pavlig43/Doz_stm32f103CBTx/kicad/README.md

# Плата дозатора

Рабочий проект — `doz_030.kicad_pro` в этой папке. Открывайте его в KiCad 10. Схема, плата и настройки проекта хранятся в одном Git-репозитории с прошивкой.

## Состав

- `doz_030.kicad_pro`, `doz_030.kicad_sch`, `doz_030.kicad_pcb` — проект, схема и плата.
- `sym-lib-table`, `fp-lib-table`, `libraries/` — местные библиотеки TrueLib и нужные детали SparkFun. Их пути заданы через `${KIPRJMOD}`.
- `models/` — все STEP-модели, назначенные деталям этой платы. Их форма и привязка сохранены; пути ведут внутрь проекта.
- `output/pdf/` — готовый лист для ЛУТ.
- `tools/build_lut_pdf.py` — сборка двух комплектов на одном листе А4.
- `AGENTS.md` — правила работы с платой и PDF.
- `docs/KICAD_3D_MODEL_ALIGNMENT.md` — правила работы с моделями.

Для открытия проекта не нужны прежняя папка `KiCadFreeCadProject`, переменная `TRUE_LIB` или отдельно установленная библиотека SparkFun. Штатные символы и посадочные места предоставляет KiCad 10; схема также содержит свои встроенные определения символов.

Локальная история редактора, файлы блокировки, временная трассировка и `codexwork/` не входят в Git.

## PDF для ЛУТ

Сначала используйте готовые исходные PDF, если они отражают нужное состояние платы. Сборка сохраняет масштаб 1:1, делает две строки и две колонки: медь слева, надписи справа. Пунктирные рамки реза идут в 1 мм от контура платы, верхняя рамка — в 5 мм от края листа; между контурами плат — 5 мм.

Нужны Python и пакеты `reportlab`, `pdfplumber`, `pypdf`. Из этой папки:

```powershell
python tools/build_lut_pdf.py --board doz_030.kicad_pcb --output output/pdf/doz_030_lut_2sets_A4.pdf --work-dir codexwork/lut_pdf --kicad-cli kicad-cli
```

Команда выводит медь и надписи из сохранённой платы, затем собирает готовый лист. Нужен `kicad-cli` из KiCad 10.

Если есть свежие исходные PDF, добавьте `--copper-pdf <PDF меди>` и `--silk-pdf <PDF надписей>`. Для уже зеркальной меди добавьте `--copper-print-ready`. Перед сборкой проверьте масштаб, отверстия и отражение.

При печати готового листа выбирайте **100%, без подгонки и без дополнительного отражения**.
