pavlig43/Doz_stm32f103CBTx/stm32f030/HARDWARE.md

# Подбор деталей для дозатора на STM32F030

## Выбранные детали питания

Питание: **12 → 5 → 3,3 В**. Берём отдельные детали для своей платы. Стабилизатор 5 В — DPAK (TO-252), стабилизатор 3,3 В — SOT-23-3, конденсаторы — 1206, под пайку паяльником.

| Узел | Деталь | Количество |
| --- | --- | ---: |
| 12 → 5 В | ST L78M05CDT-TR, 5 В, 0,5 А, DPAK (TO-252) | 1 |
| Вход L78M05CDT-TR | Керамический конденсатор 0,47 мкФ, 16 В, 1206; из корзины | 1 |
| Выход L78M05CDT-TR | Керамический конденсатор 0,1 мкФ, 6,6 В, 1206; из набора — 104M | 1 |
| 5 → 3,3 В | UMW XC6206P332MR, 3,3 В, SOT-23-3 | 1 |
| Вход XC6206P332MR | Керамический конденсатор 1 мкФ, 6,6 В, 1206; из набора — 105M | 1 |
| Выход XC6206P332MR | Керамический конденсатор 1 мкФ, 6,6 В, 1206; из набора — 105M | 1 |

Токи оценены по типовым значениям: около 72 мА от 5 В, из них около 33 мА идут через стабилизатор 3,3 В. Расчёт тепла:

- L78M05CDT-TR: `(12 − 5) × 0,072 + 12 × 0,006 ≈ 0,58 Вт`, при собственном токе 6 мА. Для отвода тепла нужна медная площадка на плате.
- XC6206P332MR: `(5 − 3,3) × 0,033 ≈ 0,056 Вт`. Нагрев небольшой, корпус SOT-23-3 подходит.

[Документ ST L78M](https://www.st.com/resource/en/datasheet/l78m.pdf), [документ UMW XC6206](https://static.chipdip.ru/lib/848/DOC018848972.pdf).

## МК и обвязка

МК — **STM32F030F4P6, TSSOP-20**, питание 3,3 В. Конденсаторы — 1206, из набора; их напряжение принимаем равным 6,6 В.

| Узел | Деталь | Количество |
| --- | --- | ---: |
| МК | STM32F030F4P6, TSSOP-20 | 1 |
| Питание VDD | Керамический конденсатор 100 нФ; в наборе — 104M | 1 |
| Питание VDD | Керамический конденсатор 4,7 мкФ; в наборе — 475M | 1 |
| Питание VDDA | Керамический конденсатор 10 нФ; в наборе — 103M | 1 |
| Питание VDDA | Керамический конденсатор 1 мкФ; в наборе — 105M | 1 |
| Сброс NRST | Керамический конденсатор 100 нФ; в наборе — 104M | 1 |
| BOOT0 к земле | Резистор 10 кОм, 1206, 1% | 1 |

Это детали сверх тех, что выбраны для стабилизаторов. Конденсаторы питания МК ставим как можно ближе к его выводам.

### Конденсаторы из набора

Всего на одну плату, включая обвязку стабилизаторов. Напряжение конденсаторов из набора принимаем равным **6,6 В**.

| Маркировка | Ёмкость | Количество |
| --- | --- | ---: |
| 103M | 10 нФ | 1 |
| 104M | 100 нФ | 3 |
| 105M | 1 мкФ | 3 |
| 475M | 4,7 мкФ | 1 |

[Документ ST STM32F030, схема питания — раздел 6.1.6](https://www.st.com/resource/en/datasheet/stm32f030c6.pdf).

## Мотор

Питание — **12 В, пусковой ток до 3 А**. Затвор IRLR2905 управляется напрямую от GPIO STM32F030 (3,3 В) через резистор.

| Узел | Деталь | Количество |
| --- | --- | --- |
| Силовой ключ | IRLR2905, DPAK (TO-252) | 1 |
| Защитный диод двигателя | SS56, 5 А, 60 В, SMC | 1 |
| Резистор между GPIO и затвором | 220 Ом, 1206, 0,125 Вт | 1 |
| Подтяжка затвора к GND | 10 кОм, 1206, 0,125 Вт | 1 |
| Подавление помех двигателя | Керамический конденсатор 100 нФ, 50 В, выводной | 1 |

### Подключение

- IRLR2905: Drain → минус двигателя, Source → GND; плюс двигателя → +12 В.
- SS56: параллельно двигателю, катод к +12 В, анод к Drain.
- Конденсатор 100 нФ: непосредственно между контактами двигателя.
- GPIO STM32 → резистор 220 Ом → Gate IRLR2905.
- Gate IRLR2905 → резистор 10 кОм → Source (GND).
- Земля STM32 и минус питания 12 В соединены.

### Логика управления

- GPIO HIGH (3,3 В) — включение двигателя.
- GPIO LOW (0 В) — выключение двигателя.
- GPIO в высокоомном состоянии — затвор стянут к GND, двигатель выключен.

Для IRLR2905 максимальное сопротивление открытого канала при 3,3 В на затворе в даташите не задано. Расчёт потерь 0,27 Вт при затворе 5 В к этой схеме не относится; потери при 3,3 В определяют по измеренному падению напряжения Drain–Source под нагрузкой: `P = I × VDS`.

Источники: [AlexGyver — драйверы коллекторных моторов, раздел «Мосфет»](https://alexgyver.ru/lessons/dc-motors/), [AlexGyver — подключение MOSFET](https://alexgyver.ru/lessons/mosfet/), [Infineon — IRLR2905](https://www.infineon.com/assets/row/public/documents/24/49/infineon-irlr2905-datasheet-en.pdf), [Pololu — подавление помех двигателя](https://www.pololu.com/docs/0J15/9).
