pavlig43/Doz_stm32f103CBTx/PROJECT_DESCRIPTION.md

# Проект весового дозатора

Состояние на 12 октября 2026 года.

## Назначение

Прошивка весового дозатора на STM32. В проекте предусмотрены измерение веса через HX711, управление мотором, LCD, энкодер с кнопкой, потенциометр и сохранение настроек во Flash.

В настройках заложены целевой вес, вес предварительной остановки, длительность импульса дозирования и коэффициент калибровки весов. Подробный порядок запуска и выполнения дозы на этом этапе не описан.

Разработка идёт на STM32F103. Для готового устройства рассматривается F0 либо тот же F103. При выборе F0 будет создан отдельный проект; точная модель пока не выбрана.

## Платформа

| Параметр | Текущий вариант |
| --- | --- |
| Микроконтроллер | STM32F103CBT6, корпус LQFP48 |
| Память по скрипту компоновки | Flash 128 КБ, RAM 20 КБ |
| Язык и библиотеки | C11, STM32 HAL |
| Среда | CLion, CMake, ARM GCC |
| Настройка периферии | STM32CubeMX, файл `Doz_stm32f103CBTx.ioc` |

## Занятые пины

| Пин | Назначение | Режим / периферия |
| --- | --- | --- |
| PA0 | Первая линия энкодера | TIM2_CH1, вход без подтяжки |
| PA1 | Вторая линия энкодера | TIM2_CH2, вход без подтяжки |
| PC13 | Кнопка энкодера, `Enc_But` | Вход с подтяжкой вверх; нажатие — низкий уровень |
| PA5 | Потенциометр, `poten` | Аналоговый вход ADC1_IN5 |
| PA9 | Управление мотором, `Motor` | GPIO push-pull, начальный уровень высокий — мотор остановлен |
| PA10 | Данные HX711, `DOUT` | Вход без подтяжки |
| PA11 | Тактовый сигнал HX711, `SCK` | GPIO push-pull, начальный уровень низкий |
| PB6 | Тактирование LCD по I2C | I2C1_SCL, alternate open-drain |
| PB7 | Данные LCD по I2C | I2C1_SDA, alternate open-drain |
| PD0 / OSC_IN | Внешний кварц | HSE |
| PD1 / OSC_OUT | Внешний кварц | HSE |
| PA13 | Отладка и прошивка | SWDIO |
| PA14 | Отладка и прошивка | SWCLK |

Пины сверены с `main.h`, `gpio.c`, настройками ADC, I2C, TIM2 и файлом CubeMX.

## Тактирование

| Узел | Частота |
| --- | --- |
| HSE, внешний кварц | 8 МГц |
| PLL | HSE × 9 |
| SYSCLK / HCLK, процессор | 72 МГц |
| APB1 | 36 МГц |
| Таймеры APB1, в том числе TIM2 | 72 МГц |
| APB2 | 72 МГц |
| TIM1 | 72 МГц при текущей настройке APB2 |
| ADC1 | 12 МГц, APB2 / 6 |

TIM2 получает 72 МГц, хотя APB1 работает на 36 МГц: при делителе APB1 равном 2 частота таймеров удваивается относительно частоты шины.

## Таймеры и периферия

| Узел | Назначение и настройка | Состояние |
| --- | --- | --- |
| TIM2 | Энкодер, режим TI12; `PSC = 0`, `ARR = 65535`; фильтры входов CH1 = 5, CH2 = 0 | Настроен в `tim.c`; запуск счёта находится в `Enc_Init()` |
| TIM1 | Короткие паузы при чтении HX711; внутренний счётчик с шагом 1 мкс, без GPIO и прерываний | Настроен в `tim.c`; запуск находится в `HX_Init()` |
| SysTick | Системное время HAL, `HAL_GetTick()` и `HAL_Delay()` | Используется HAL |
| ADC1 | Один канал IN5, 12 бит, одиночное преобразование с программным запуском | Настроен; `poten.c` читает 0…4095 и переводит в заданный диапазон |
| I2C1 | LCD 16×2, скорость 100 кГц; 7-битный адрес дисплея `0x27` | Настроен; в вызов HAL адрес передаётся как `0x27 << 1` |

TIM3 и TIM4 в текущем проекте не настроены. TIM1 для задержек не требует перенастройки PA9, PA10 или PA11: эти пины остаются GPIO.

В `enc.c` четыре отсчёта TIM2 объединяются в один шаг энкодера. В `lcd.c` хранятся две строки по 16 символов; проверка обновления идёт с интервалом 200 мс, передаются изменившиеся строки.

В `motor.c` заложены уровни: низкий — пуск, высокий — остановка. Управление идёт через GPIO, ШИМ для мотора сейчас не настроен. При запуске вызывается `Motor_Stop()`; пуск мотора пока не подключён.

## Настройки и калибровка

| Настройка | Значение по умолчанию | Хранение |
| --- | --- | --- |
| Целевой вес | 3000 г | `FEE_WEIGHT`, ID 0 |
| Коэффициент HX711 | `1.0f` | Младшие 16 бит — ID 1, старшие — ID 2 |
| Вес предварительной остановки | 50 г | `FEE_STOP_BEFORE_TARGET_WEIGHT`, ID 3 |
| Длительность импульса дозирования | 500 мс | `FEE_TIME_DOSING_PULSE`, ID 4 |

В текущем коде калибровки сначала усредняются пять отсчётов без груза, затем пять отсчётов с грузом 1 кг. Коэффициент рассчитывается как `(raw_1kg - raw_zero) / 1000`, то есть число отсчётов на грамм. Перевод отсчёта в граммы: `(raw - raw_zero) / factor`.

Настройки сохраняются модулем `fee.c` во Flash: начало `0x0800FC00`, размер страницы 1024 байта, номер страницы 63. Это адрес, заданный в коде; для STM32F103CB со 128 КБ Flash эта страница не последняя.

Запись занимает четыре байта: 16-битный ID и 16-битное значение. Чтение выбирает последнюю запись с нужным ID. При заполнении страницы код стирает её и переносит текущие значения. Биты коэффициента `float` хранятся в двух записях. `FEE_Settings_Init()` загружает настройки и восстанавливает коэффициент.

## Основные файлы

Пути ниже указаны от корня проекта. Код CubeMX остаётся в `Core`, HAL и CMSIS — в `Drivers`. Наши библиотеки лежат в `lib`, код дозатора — в `app`. Файлы `.c` и `.h` каждого нашего модуля лежат рядом. В корне `app` лежат `app.c` и `app.h`; модули `work`, `settings` и `doz_fee` имеют свои папки.

| Файл / модуль | За что отвечает |
| --- | --- |
| `Core/Src/main.c` | Запуск HAL, настройка частот и периферии |
| `Core/Src/gpio.c`, `adc.c`, `i2c.c`, `tim.c` | Настройки периферии, созданные CubeMX |
| `lib/hx/hx.c` | Чтение HX711 с паузами через TIM1, среднее пяти проб, тара и вес в граммах |
| `lib/enc/enc.c` | Энкодер и короткое / длинное нажатие кнопки |
| `lib/lcd/lcd.c` | Запуск и вывод двух строк LCD |
| `lib/fee/fee.c` | Хранение записей во Flash |
| `lib/motor/motor.c` | Управление мотором |
| `lib/poten/poten.c` | Чтение потенциометра |
| `lib/utils/utils.c` | Пересчёт диапазона значений |
| `app/settings/settings.c` | Меню настроек и калибровка весов |
| `app/doz_fee/doz_fee.c` | Параметры дозатора и загрузка из Flash |
| `app/app.c` | Главное меню и выбор режима |
| `app/work/work.c` | Рабочий режим пока пуст |

Перенос меняет только пути: функции, их вызовы и связи между модулями сохранены. `main.c` остаётся прежним; сборка находит заголовки через пути из корневого `CMakeLists.txt`. Файлы в `cmake/stm32cubemx` остаются под управлением CubeMX. Модуль `hx` пока связан с `doz_fee`.

## Текущее состояние

В `main.c` настроены GPIO, ADC1, I2C1, TIM2 и TIM1. При запуске мотор останавливается, ADC проходит калибровку, загружаются настройки Flash, запускаются HX711, LCD и энкодер. Основной цикл опрашивает энкодер и кнопку, вызывает меню и обновляет LCD.

Рабочий режим пока пуст. Кнопка читается опросом с фильтром дребезга 30 мс; порог длинного нажатия — 600 мс. Длинное нажатие возвращает в меню. Меню даёт доступ к настройкам и калибровке по пяти новым пробам без груза и с грузом 1 кг. Алгоритм дозирования ещё не написан.

Обсуждение чтения HX711 через TIM1 сохранено в [HX711_TIM1.md](HX711_TIM1.md); текущий код находится в `lib/hx/hx.c`.

Последняя сборка Release с суммами HX711 на `int32_t` и пустым рабочим режимом прошла без ошибок и предупреждений: 14 252 байта Flash и 2432 байта RAM. Короткое и длинное нажатия, дребезг и переход счётчиков через ноль проверены на ПК с подменой HAL. На плате прошивка не проверялась.
