pavlig43/Doz_stm32f103CBTx/PROTEUS_PROGRESS.md

# Дозатор в Proteus 8.13: что сделано и где остановились

Состояние на 17 октября 2026 года.

Проект прошивки: `C:\Users\user\CLionProjects\Doz_stm32f103CBTx`.

Этот файл дополняет `PROTEUS_HANDOFF.md`. Старый файл содержит общий план дозатора; здесь записан ход работы с библиотеками и схемой мотора.

## LCD: запуск подтверждён 17 октября 2026 года

В схеме `C:\Users\user\Documents\New Project.pdsprj` нашли разрыв: SDA и SCL экрана не входили в цепи PB7 и PB6. После соединения проводами LCD начал принимать данные. Прибор I2C и резисторы подтяжки должны быть подключены к этим же цепям; совпадение видимых подписей ещё не доказывает контакт.

Затем модель TEP сообщила `TOO FAST`, а вместо текста были неверные символы. В `LCD_Init()` первые посылки шли через передачу полного байта, что сбивало переход в 4-битный режим. Проверенная правка сначала сбрасывает E, затем передаёт одиночные полубайты 3, 3, 3, 2 с задержками. Пользователь подтвердил, что с ней экран заработал.

Этот же код перенесён в `lib/lcd/lcd.c`. После очистки оставлен один ELF: `C:\Users\user\CLionProjects\Doz_stm32f103CBTx\build\Debug\Doz_stm32f103CBTx.elf`. Обычный профиль CLion `Debug - Debug` теперь собирает его с `-O0 -g3 -gdwarf-2`; ASM тоже использует DWARF 2. `cmake/proteus-debug.cmake` готовит в каталоге сборки стандартные библиотеки без их старых отладочных данных DWARF 5. Проверено: все 25 отладочных единиц итогового ELF имеют версию 2, а код Flash побайтно совпадает с проверенной пользователем версией. Новую версию на реальной плате ещё не проверяли; прежняя версия там работала со слов пользователя.

По прямому запросу пользователя удалены отдельные сборки ProteusDwarf2 и ProteusLcdInit, диагностические дампы, старый ELF Release, ELF без отладочных данных и старая схема `simulation/proteus/Doz_STM32F103C8.pdsprj` с копиями. Сохранены только два проекта схем: `C:\Users\user\Documents\New Project.pdsprj` и `C:\Users\user\Documents\Doz_STM32F030F4P6TR.pdsprj`. Их резервные копии удалены; новые копии не создавать. Сами два проекта при очистке не менялись. В сохранённом New Project ещё указан старый путь ProteusLcdInit: в U1 нужно выбрать единственный ELF из Debug.

## Как продолжать

Пользователь сам ставит детали и соединяет их в Proteus. Агент ведёт его по шагам: по 1–3 действия, затем проверка по ответу или скриншоту. Для каждого соединения указывать оба конца. Не считать схему готовой по одному виду подписей.

## Что проверили и установили

- Пользователь перешёл на Proteus 8.13. Проверенная версия `PDS.EXE` — `8.13.31525`.
- Папка установки: `C:\Program Files (x86)\Labcenter Electronics\Proteus 8 Professional`.
- По одному номеру версии нельзя судить о числе моделей. Состав библиотек зависит и от сторонних файлов; совместимость каждой модели надо проверять отдельно.
- Прошивку в ходе этой работы не меняли. Симуляцию всего дозатора ещё не проверяли.

### LCD 16×2 с I2C в одной детали

Нашли штатную деталь `JHD-2X16-I2C`, но она не заменяет связку LCD + PCF8574 для текущего драйвера прошивки.

Установили библиотеку TEP с LCD и PCF8574 в одной детали:

- `C:\Program Files (x86)\Labcenter Electronics\Proteus 8 Professional\DATA\LIBRARY\TEPLCD.LIB`
- `C:\Program Files (x86)\Labcenter Electronics\Proteus 8 Professional\DATA\MODELS\TEPLCD.DLL`

В поиске деталей вводить `I2CLCD16X2`; выбранный вариант — `I2CLCD16X2BLUETEP`.

Для прошивки нужен адрес `0x27` и связи PCF8574: P0 → RS, P1 → RW, P2 → E, P3 → подсветка, P4…P7 → D4…D7. При выборе модели сверили эти параметры. Работу экрана с прошивкой ещё надо проверить запуском.

Архив и распакованные файлы лежат в `C:\Users\user\Downloads\Proteus-LCD-I2C-TEP`.

Источник: [LCD Library for Proteus V3.0, TEP](https://www.theengineeringprojects.com/2026/10/lcd-library-for-proteus-v30.html).

### Поиск модуля мотора

Сначала установили библиотеку `L298MotorDriverTEP`, но пользователь отверг этот вариант: много выводов, не похож на его модуль. В текущей схеме L298 не нужен; его библиотеку не удаляли.

У физического модуля пользователя пять выводов:

| Надпись | Назначение |
| --- | --- |
| `+` | Плюс питания мотора |
| `−` | Минус питания мотора |
| `LOAD` | Выход к минусу мотора |
| `GND` | Земля входного сигнала |
| `PWM` | Вход управления |

По этим выводам модуль похож на платы LR7843 / D4184 / FR120N с оптопарой. Точную модель платы не установили. Готовую подходящую модель Proteus не нашли.

Решили собрать аналог на PC817 и IRLZ44N, затем сохранить его для повторного применения. Это схема для проверки работы дозатора; точное совпадение с внутренней схемой физического модуля не доказано.

## Что уже стоит на листе

По последнему скриншоту пользователь разместил:

| Деталь | Обозначение и значение |
| --- | --- |
| Источник питания | BAT1, 12 V |
| Мотор | MOTOR-DC |
| MOSFET | Q1, IRLZ44N |
| Оптопара | U2, PC817 |
| Резистор входа оптопары | R1, 330 Ом |
| Подтяжка затвора | R2, 10 кОм |
| Резистор затвора | R3, 100 Ом |
| Диод мотора | D1, 1N4007 |

Изначально предлагали 1N5819, но в установке его не нашли. Остановились на доступном 1N4007. Его допустимый средний ток — 1 А, не 1 мА. Для быстрой ШИМ выбор диода надо пересмотреть; текущая прошивка включает и выключает мотор медленными импульсами.

## Связи через имена без длинных проводов

Показали режим `TERMINALS` → `DEFAULT`. Две клеммы с одним именем образуют одну электрическую цепь. Так соединяем, например, мотор и сток Q1 через имя `LOAD`.

Длинный провод между ними не нужен. Точка подключения клеммы должна точно совпасть с концом вывода на сетке. Если между ними есть зазор, нужен короткий провод. Надпись рядом с выводом сама по себе его не соединяет.

## Где остановились: у Q1 перепутаны две клеммы

На последнем скриншоте:

- Плюс BAT1 связан с цепью `12V`, минус — с `GND_INPUT`.
- Один вывод мотора связан с `12V`, другой — с `LOAD`.
- **У Q1 верхний вывод ошибочно связан с `GND_INPUT`, нижний — с `LOAD`.**
- R1, R2, R3 и U2 ещё не соединены. D1 тоже ещё не соединён.

Последнее указание пользователю — поменять у Q1 две клеммы:

| Вывод Q1 IRLZ44N в текущем положении | Нужная цепь |
| --- | --- |
| Верхний D, № 2 — сток | `LOAD` |
| Нижний S, № 3 — исток | `GND_INPUT` |
| Левый G, № 1 — затвор | Пока свободен; подключим через R3 |

Пользователь спросил, что перепутано, если G свободен. Уточнили: речь о D и S; свободный G к этой ошибке не относится. Подтверждения, что клеммы уже переставлены, пока нет.

Последний скриншот: `C:\Users\user\AppData\Local\Temp\codex-clipboard-c8edd13f-8dc7-4f21-8fc0-0070319277e5.png`.

## Как завершить схему мотора

Ниже — намеченные связи, а не отчёт о готовой схеме. Давать их пользователю небольшими порциями.

### Силовая часть

1. Плюс питания 12 V → один вывод мотора.
2. Второй вывод мотора → `LOAD` → D Q1, № 2.
3. S Q1, № 3 → минус питания мотора. На текущем листе эта цепь называется `GND_INPUT`.
4. Катод D1, сторона с чертой → `12V`.
5. Анод D1 → `LOAD`.

В текущем положении D1 катод справа, анод слева. Диод подключается параллельно мотору.

### Вход и затвор: низкий уровень включает мотор

В `lib\motor\motor.c` проверено: `Motor_Run()` задаёт низкий уровень, `Motor_Stop()` — высокий. Поэтому для этого аналога намечена схема с таким же действием входа.

Выводы PC817 на скриншоте: A № 1 сверху слева, K № 2 снизу слева, C № 4 сверху справа, E № 3 снизу справа.

| Откуда | Куда |
| --- | --- |
| Вход `PWM` от PA9 | R1, 330 Ом |
| Другой конец R1 | A PC817, № 1 |
| K PC817, № 2 | Сигнальная земля `GND` контроллера |
| C PC817, № 4 | Узел `GATE_CTL` |
| E PC817, № 3 | Минус питания мотора, сейчас `GND_INPUT` |
| `12V` | R2, 10 кОм |
| Другой конец R2 | `GATE_CTL` |
| `GATE_CTL` | R3, 100 Ом |
| Другой конец R3 | G Q1, № 1 |

При высоком уровне на `PWM` оптопара открывается и тянет затвор вниз: мотор выключен. При низком уровне оптопара закрыта, R2 поднимает затвор к 12 V: мотор включён.

Название `GND_INPUT` на текущем листе относится к минусу батареи. Не путать его с отдельным входом `GND` оптопары. Если нужно сохранить развязку, не объединять эти цепи общей меткой земли. Перед сборкой входной части проверить, какие сети создают выбранные символы в Proteus.

PC817 и подтяжка 10 кОм выбраны для медленного включения и выключения в этой проверке. Работу на высокой частоте ШИМ не проверяли. При отключённом входе эта схема включает мотор через R2; остановка при обрыве входа здесь не обеспечена.

## Что ещё проверить

- Исправлены ли D и S Q1 и есть ли электрический контакт у всех клемм.
- Правильно ли подключён диод.
- Выключается ли мотор при высоком уровне входа и включается ли при низком.
- Как ведёт себя схема при запуске прошивки. В старой памятке отмечен возможный низкий начальный уровень PA9; актуальное состояние запуска заново не проверяли.
- Работает ли LCD с текущей прошивкой. Наличие файлов библиотеки ещё не доказывает работу модели.

## Сохранение модуля

Пользователь хочет сгруппировать схему и сохранить блок с пятью выводами. До этого надо завершить связи и проверить пуск и остановку мотора.

В местной справке Proteus нашли два пути:

- Плоский фрагмент схемы можно сохранить как Project Clip (`.PDSCLIP`).
- Для детали с пятью внешними выводами подходит иерархическая схема с внешним файлом `.MOD` и сохранением детали в библиотеку через `Make Device`.

Project Clip не сохраняет содержимое дочерних листов. Нельзя упаковать только внешний блок и считать, что его внутренняя схема тоже попала в клип.

Ни клип, ни готовую деталь пока не создали. Путь к сохранённому проекту Proteus ещё не подтверждён. По общему плану его нужно сохранить в `simulation\proteus\` внутри проекта прошивки.

## Следующий шаг

Проверить по новому скриншоту, что у Q1 верхний D связан с `LOAD`, нижний S — с минусом батареи. Затем подключить D1: катод к `12V`, анод к `LOAD`. После этого перейти к PC817 и резисторам.
