pavlig43/Doz_stm32f103CBTx/kicad/docs/KICAD_3D_MODEL_ALIGNMENT.md

# Работа с 3D-моделями в KiCad

Это главная инструкция для моделей X3D, STEP и FCStd, связанных с футпринтами KiCad. При любой задаче по 3D сначала читать этот файл. Работать по одной модели. KiCad и FreeCAD для проверки вида открывает пользователь сам.

## Главное правило

- «Повернуть» — изменить угол в плоскости платы вокруг Z; высота не меняется. «Развернуть» — перевернуть модель вокруг X или Y.
- Сначала определить, что просит пользователь: изменить файл модели или только её привязку в футпринте. Не подменять одно другим.
- Если пользователь дал путь к STEP, X3D или FCStd либо прямо назвал формат, менять только этот файл. Не менять `.kicad_pcb`, `.kicad_mod`, `offset`, `scale` и `rotate`, даже если ошибка показана в 3D-виде KiCad.
- Файл по доступному локальному пути уже передан для работы. Не просить пользователя прислать или загрузить его в чат.
- При правке файла модели не менять футпринт, площадки, плату и `offset`, `scale`, `rotate`. При правке одной привязки не менять STEP, X3D или FCStd.
- Править ровно тот файл, на который указывает футпринт. Не менять системные модели KiCad, не создавать ссылки, junction и каталоги-накладки.
- Для полного комплекта детали копировать модель в `${MY_LYB}/my_lyb.3dshapes` и ссылаться на неё через `${MY_LYB}`. Не оставлять ссылку на системную модель или случайную копию.
- Не создавать рядом второй файл с тем же именем. Временные файлы держать вне библиотеки.
- До правки отделить ручные изменения пользователя от изменений агента. Ручные правки не отменять.
- Не менять готовую модель без прямого запроса пользователя.
- Масштаб не менять без доказанной ошибки единиц. Если размер модели не совпадает с футпринтом, сообщить точные числа и остановиться.
- Не угадывать по косому снимку. Фото используют только как подсказку; решение принимают по координатам, виду сверху и трём опорным точкам.
- Менять один параметр за раз: X/Y, Z, угол, зеркало, масштаб или форму. После каждой правки делать одну короткую проверку.

## Подготовка

1. Из футпринта выписать путь модели, `offset`, `scale`, `rotate`, угол футпринта и координаты всех нужных площадок.
2. Сверить путь `my_lyb` в таблице футпринтов, значение `${MY_LYB}` и наличие файла.
3. Выбрать опорные точки:
   - центр первого отверстия или вывода задаёт сдвиг;
   - центр второго задаёт поворот и шаг;
   - третья точка вне этой линии проверяет зеркало и сторону.
4. Сравнивать центры отверстий и выводов, а не края корпуса, цвет, пластик или положение надписей.
5. Для рядов контактов проверить число контактов и шаг `2,54 мм` или тот шаг, который указан в футпринте.
6. Для размеров брать источники в таком порядке: прямое указание пользователя, назначенный верным чертёж или футпринт, исходная модель, фото только для вида и стороны установки.

## Расчёт координат

- Сначала считать координаты самой модели, затем применить преобразования футпринта. Нельзя считать сдвиг, забыв про `offset` или поворот.
- Записать формулу и единицы: X3D обычно использует дюймовые единицы VRML/X3D, STEP — миллиметры. Перевод X3D: `1 единица = 2,54 мм`.
- Для X3D учитывать порядок преобразований KiCad: сначала `offset`, затем поворот модели и масштаб. При повороте модели локальные координаты могут поменяться местами по осям; знак оси нельзя выбирать на глаз.
- Для STEP определить, как оси модели соотносятся с осями футпринта. У STEP ось Y может иметь обратный знак относительно вида KiCad.
- Считать одну жёсткую матрицу: перенос и поворот. Зеркало применять только после проверки третьей точки и сообщения пользователю.
- Не менять масштаб как способ исправить сдвиг. Сдвиг исправляется сдвигом, поворот — поворотом.

## X3D

- Сохранять исходную структуру X3D и штатные узлы модели.
- Не добавлять общий узел `kicad_alignment_TRANSFORM`, скрытый корневой перенос или другую временную обёртку. Если такой узел уже добавлен прошлым агентом, перед новой правкой удалить его и вернуть исходную структуру.
- Менять координаты геометрии и штатные `Transform` модели. Не двигать отдельные детали по одной, если ошибка общая для всей модели.
- Для рядов штырей, колодок и разъёмов совмещать оси штырей с центрами отверстий или площадок именно своего футпринта. Проверять число контактов, шаг, сторону колодки, длину выводов и высоту над платой.
- Для деталей, не относящихся к PLS, размеры, форма пластика и длина штырей не считаются стандартными: брать их из исходной модели, чертежа или данных пользователя. Не переносить размеры другой детали.
- Сначала совмещать центры по X и Y, затем проверять общий Z. Не опускать и не поднимать штыри без измерения от плоскости платы.

### PLS и BLS

- Для одного контакта хранить прямой и угловой 90° варианты.
- Исходник для FreeCAD — `.FCStd`, модель для KiCad и обмена — `.step`.
- Размеры ножек должны быть видны в свойствах объектов, а не только внутри слитого тела.

#### Прямые штыри PLS

- Чёрная колодка располагается под платой, длинные концы штырей направлены вниз, короткие проходят через плату вверх.
- Шаг ряда — `2,54 мм`. Оси штырей совмещать с центрами отверстий. Край колодки выступает на `1,27 мм` от оси крайнего штыря.
- От низа платы колодка занимает высоту от `0` до `-2,5 мм`, штыри — от `-8,5` до `+3,25 мм`.
- Сечение штыря — `0,75 × 0,75 мм`. В ряду брать только нужное число мест.
- Если оси модели направлены иначе, поворачивать весь ряд, сохраняя шаг, центры и высоты.

## STEP и FCStd

- STEP править скриптом через Python API FreeCAD, запускать скрипт в `FreeCADCmd`. Окно FreeCAD не открывать и не править модель вручную через интерфейс.
- Править любую STEP-модель через `Placement` в FreeCAD: перенос, поворот и при необходимости зеркало. Форму деталей не менять, если пользователь не просил изменить форму.
- Исходный STEP не перезаписывать до сохранения резервной копии или отдельного исходника. Рабочий итог сохранять по тому же пути только после расчёта и проверки чисел.
- FCStd хранить отдельно от экспортированного STEP. В FCStd проверять дерево объектов, единицы, оси и положение относительно плоскости платы.
- После изменения FCStd экспортировать STEP заново с сохранением единиц и ориентации. Не править STEP как обычный текст.
- Для деталей с выводами совмещать минимум два центра выводов и одну точку вне их ряда. Это выявляет сдвиг, угол и зеркало.
- У сборочного STEP сохранять дерево, цвета и взаимное положение частей. Не выгружать сборку как набор отдельных тел.
- При общем переносе или повороте менять одной матрицей все размещения, перечисленные в корневом узле. Не двигать тела по одному и не менять общий единичный узел, от которого зависят связи.
- FreeCAD может показать `Placement` корневого `App::Part`, но не включить его в экспортированный STEP. Успешный экспорт не доказывает, что сдвиг и поворот записались.
- До выгрузки создать временную папку и проверить, что она существует. После ошибки команды не продолжать и не писать в исходный STEP.
- Сначала выгружать пробный STEP во временную папку, заново открывать именно этот файл и сверять его координаты с расчётом. Исходный STEP заменять только после этой проверки.
- Если после повторного открытия координаты не изменились, оставить `Placement` корневого `App::Part` единичным и умножить одной и той же жёсткой матрицей размещения всех его прямых дочерних частей. Список брать из корневого узла, а не из заранее заданного числа тел.
- Не применять матрицу ко всем `Part::Feature` подряд: вложенная часть может получить двойной сдвиг или поворот. После новой выгрузки ещё раз открыть STEP и проверить габариты, опорные точки и диапазон Z.

## Новая модель FCStd

- STEP брать как образец формы и размеров, а итог строить нативными объектами FreeCAD.
- Начало координат, плоскость установки и оси X/Y/Z связывать с футпринтом. Не переносить модель в центр ради удобного вида.
- Дерево держать чистым: корневой узел, плата, отверстия, крупные детали и разъёмы. Не оставлять импортированный STEP, дубли и черновики.
- Не рисовать текст, дорожки и мелкий декор без прямого запроса.
- Перед сохранением проверить единицы, число выводов, соосность отверстий, сторону пластика и высоты над и под платой.

## Числовая проверка до сохранения

- Преобразовать все точки модели в координаты футпринта с учётом `offset`, `rotate` и `scale`.
- Сравнить каждый проверенный центр с площадкой. Для каждой точки записать `ΔX`, `ΔY` и итоговое расстояние.
- Допуск итогового расстояния — `0,05 мм`. Если хотя бы одна точка вне допуска, модель не сохранять и искать причину: неверная ось, знак, угол, единицы или лишний старый сдвиг.
- Не считать совпадением ситуацию, когда совпал только край, один вывод или косой ракурс.

## Проверка в KiCad

- Проверить путь модели, наличие файла, начало координат, ориентацию и связь с футпринтом отдельно от знака и площадок.
- Проверить вид сверху, затем вид сбоку и косой вид. Вид сверху показывает X/Y, угол и зеркало; вид сбоку — Z.
- STEP сам не вырезает плату. Если в 3D-виде пропал кусок платы, искать замкнутый контур на `Edge.Cuts`.
- В `.kicad_pcb` хранится копия футпринта. После правки библиотечного футпринта вызвать `Инструменты → Обновить посадочные места из библиотеки…`.

## Типовые ошибки

| Симптом | Причина | Что делать |
|---|---|---|
| После экспорта пропали выводы, появилась лишняя деталь или части наложились | Сборочный STEP выгружен как отдельные тела | Вернуть исходный STEP и менять общее размещение сборки |
| Края совпали, но выводы не попали в площадки | Совмещение сделано по корпусу или снимку | Сверять центры площадок и минимум три опорные точки |
| Центры совпали, но номера выводов идут наоборот | Не проверена сторона ряда | Сопоставить физические выводы с номерами площадок и проверить третью точку |
| Модель перевернулась верхом вниз вместо поворота в плане | Перепутаны оси | Для поворота брать Z; разворот вокруг X или Y переворачивает модель |
| Штыри ушли в плату или модель висит над ней | Вместе с X/Y изменён Z | Вернуть прежний Z и считать высоту отдельно |
| После сдвига часть сборки осталась на месте | Изменены не все верхние размещения | Применить одну матрицу ко всем дочерним размещениям корневого узла |
| После общей правки детали продублировались или разъехались | Изменён общий узел, от которого зависят связи | Вернуть общий узел и править перечисленные в нём размещения |
| В FreeCAD сборка сдвинулась или повернулась, а повторно открытый STEP остался прежним | Экспорт не включил `Placement` корневого `App::Part` | Оставить корень единичным, применить одну матрицу к его прямым дочерним размещениям, выгрузить пробный STEP и открыть его заново |
| Плата выглядит по-старому после правки футпринта | В плате осталась старая копия футпринта | Обновить посадочные места из библиотеки |
| Размер модели не совпадает с футпринтом | Ошибка единиц или масштаба | Сравнить точные размеры; масштаб на глаз не подбирать |
| По снимку неясен знак оси или зеркало | Косой вид искажает расстояния | X/Y и угол проверять по координатам и виду сверху |

## Сохранение и отчёт

- Сохранить только то, что просил изменить пользователь: файл модели или её привязку в футпринте. Знак, плату и чужие модели не менять.
- Удалить временные файлы проверки и не оставлять рядом вторую модель с тем же именем.
- В отчёте указать путь модели, что изменено, точный перенос по X/Y/Z, поворот, зеркало, масштаб и таблицу отклонений.
- Явно сообщить, если масштаб не менялся. Если применено зеркало или изменены единицы, отдельно предупредить пользователя.
- После каждой модели остановиться. Пользователь сам открывает KiCad/FreeCAD и проверяет вид сверху, затем косой вид и высоту. К следующей модели переходить только после его ответа.

## Ошибки, которые нельзя повторять

- Не править футпринт, чтобы скрыть ошибку модели.
- Не возвращать общий Z к нулю после того, как высота уже совпала.
- Не опускать штыри или пластик колодки без измерения от плоскости платы.
- Не утверждать, что «всё совпало», по одному косому снимку.
- Не ссылаться на ошибку KiCad без проверки собственных `offset`, `rotate`, осей и лишних узлов X3D.
- Не менять сразу X, Y, Z, угол и масштаб: иначе нельзя понять, что помогло.
- Не переходить к следующей детали, пока пользователь не подтвердил текущую.
