pavlig43/Doz_stm32f103CBTx/hardware/doz_030_lut_2sets_A4.pdf

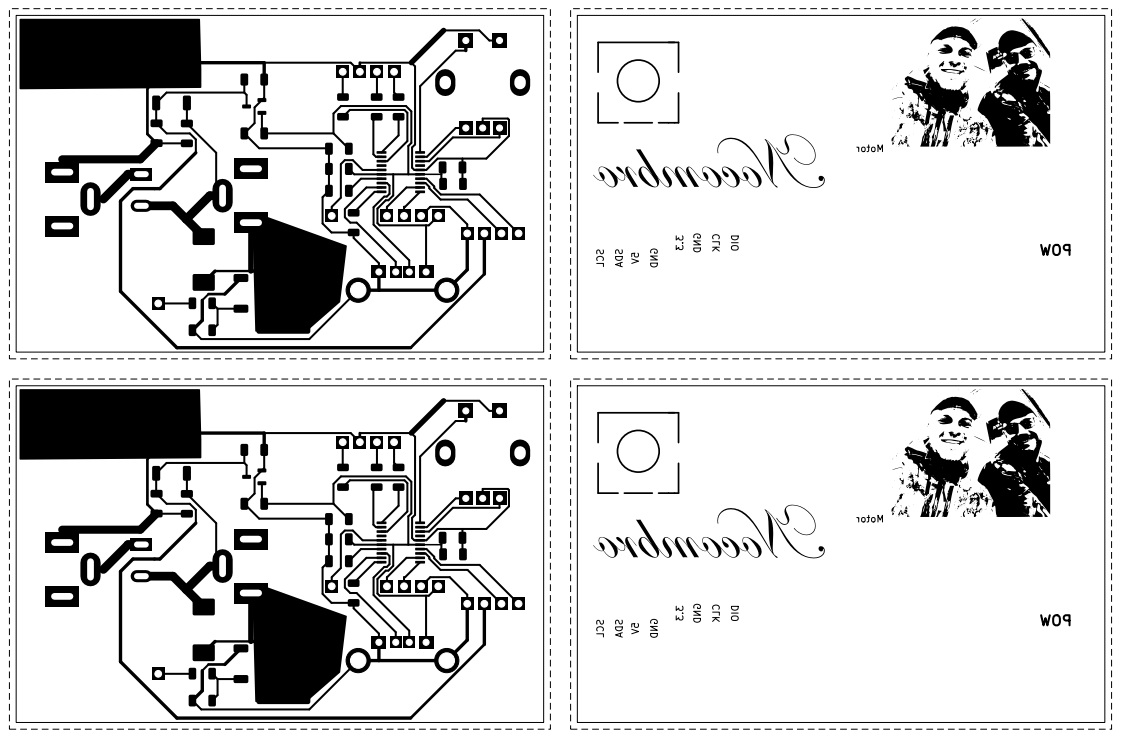
[picture p1: page 1]

SCL SDA 5V GND 3.3 GND CLK DIO POW
