pavlig43/Doz_stm32f103CBTx/kicad/doz_030-B_Silkscreen.pdf

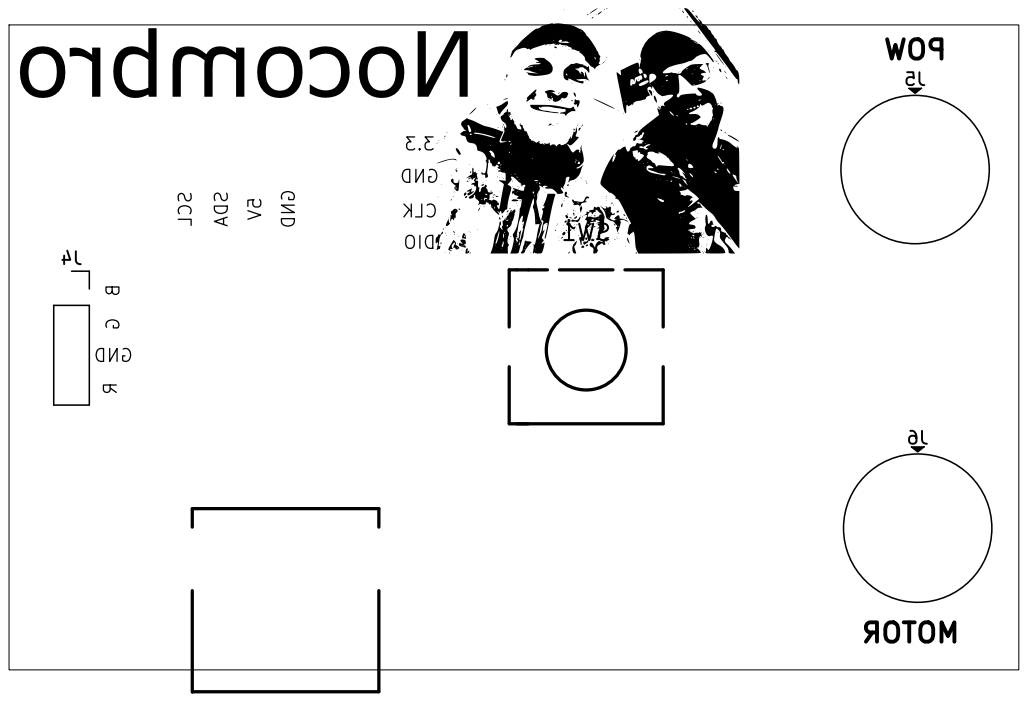
[picture p2: page 1]

GNDR MOTOR SCL SDA 5V GND
