pavlig43/Doz_stm32f103CBTx/kicad/output/pdf/doz_030_lut_2sets_A4_2026-10-29.pdf

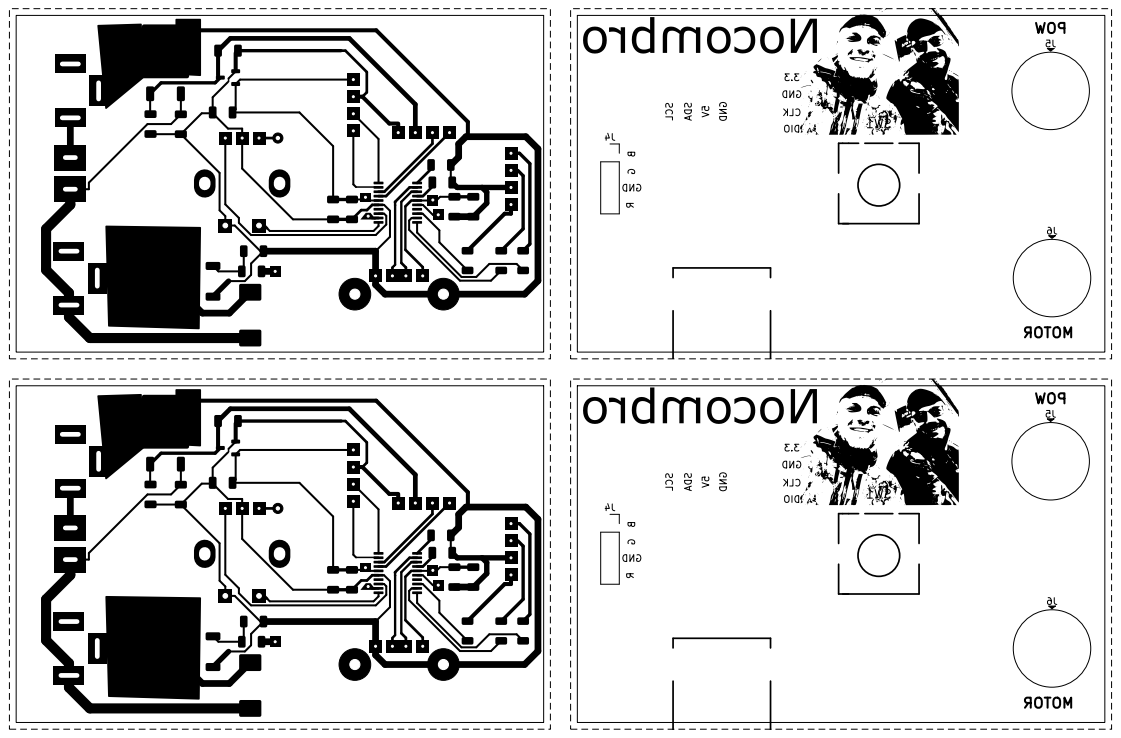
[picture p3: page 1]
GND; 3.3 DIO; CLK; GND R B G POW; MOTOR

J5 SCL SDA 5V GND

SCL SDA 5V GND
