pavlig43/Doz_stm32f103CBTx/doz_030_klem/doz_030_klem-B_Silkscreen.pdf

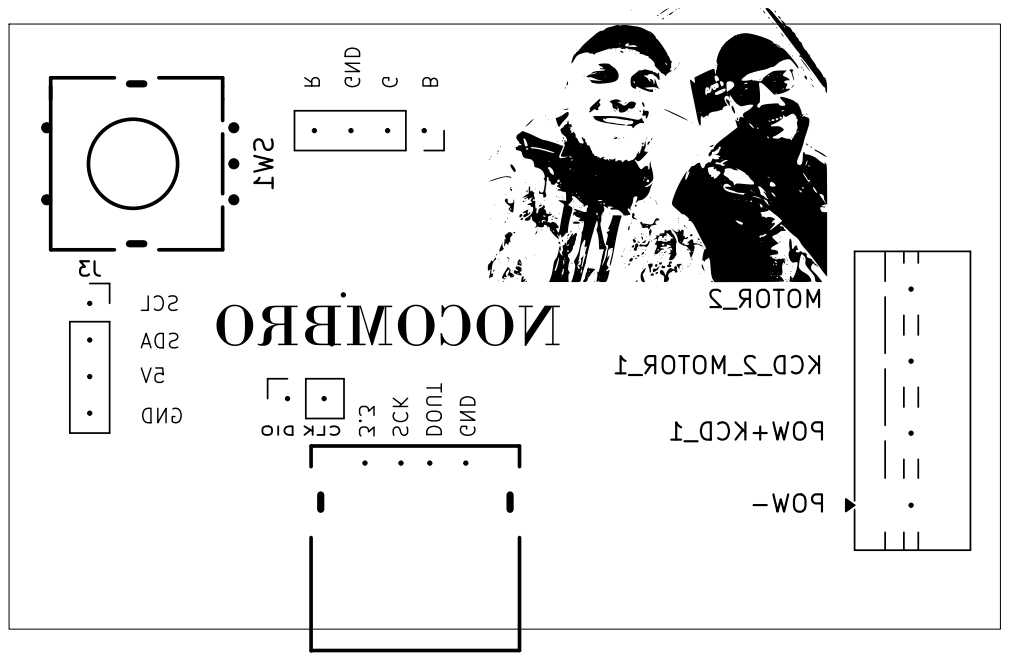
[picture p4: page 1]
