pavlig43/Doz_stm32f103CBTx/doz_030_klem/doz_030_klem-F_Cu.pdf

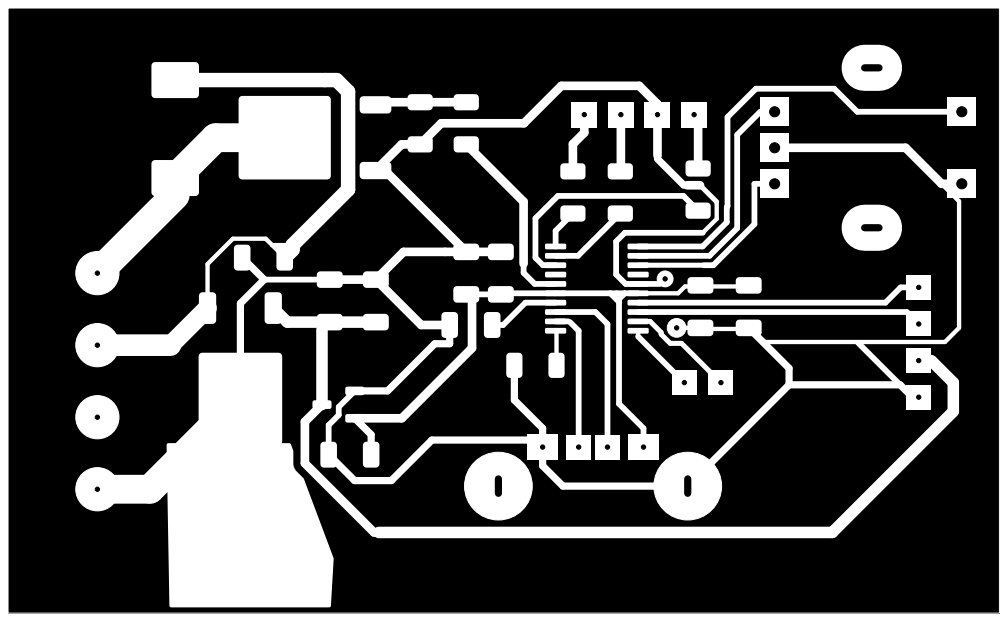
[picture p5: page 1]
