pavlig43/Doz_stm32f103CBTx/kicad/doz_030-F_Cu.pdf

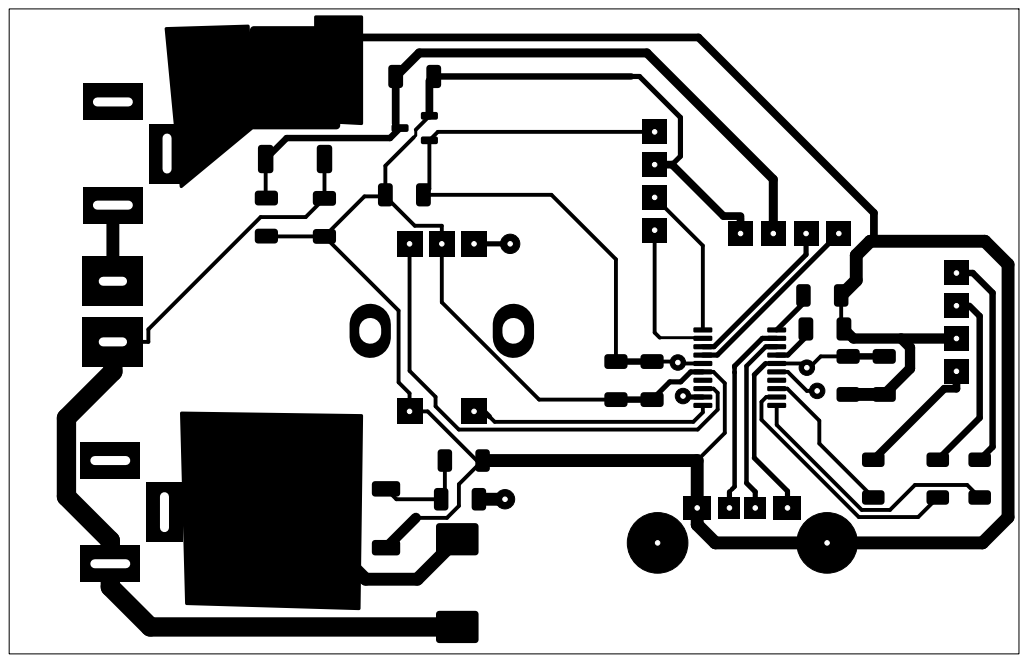
[picture p6: page 1]
