pavlig43/Doz_stm32f103CBTx/doz_030_klem/doz_030_klem.kicad_pcb

## KiCad design doz_030_klem/doz_030_klem.kicad_pcb (2026-11-06)

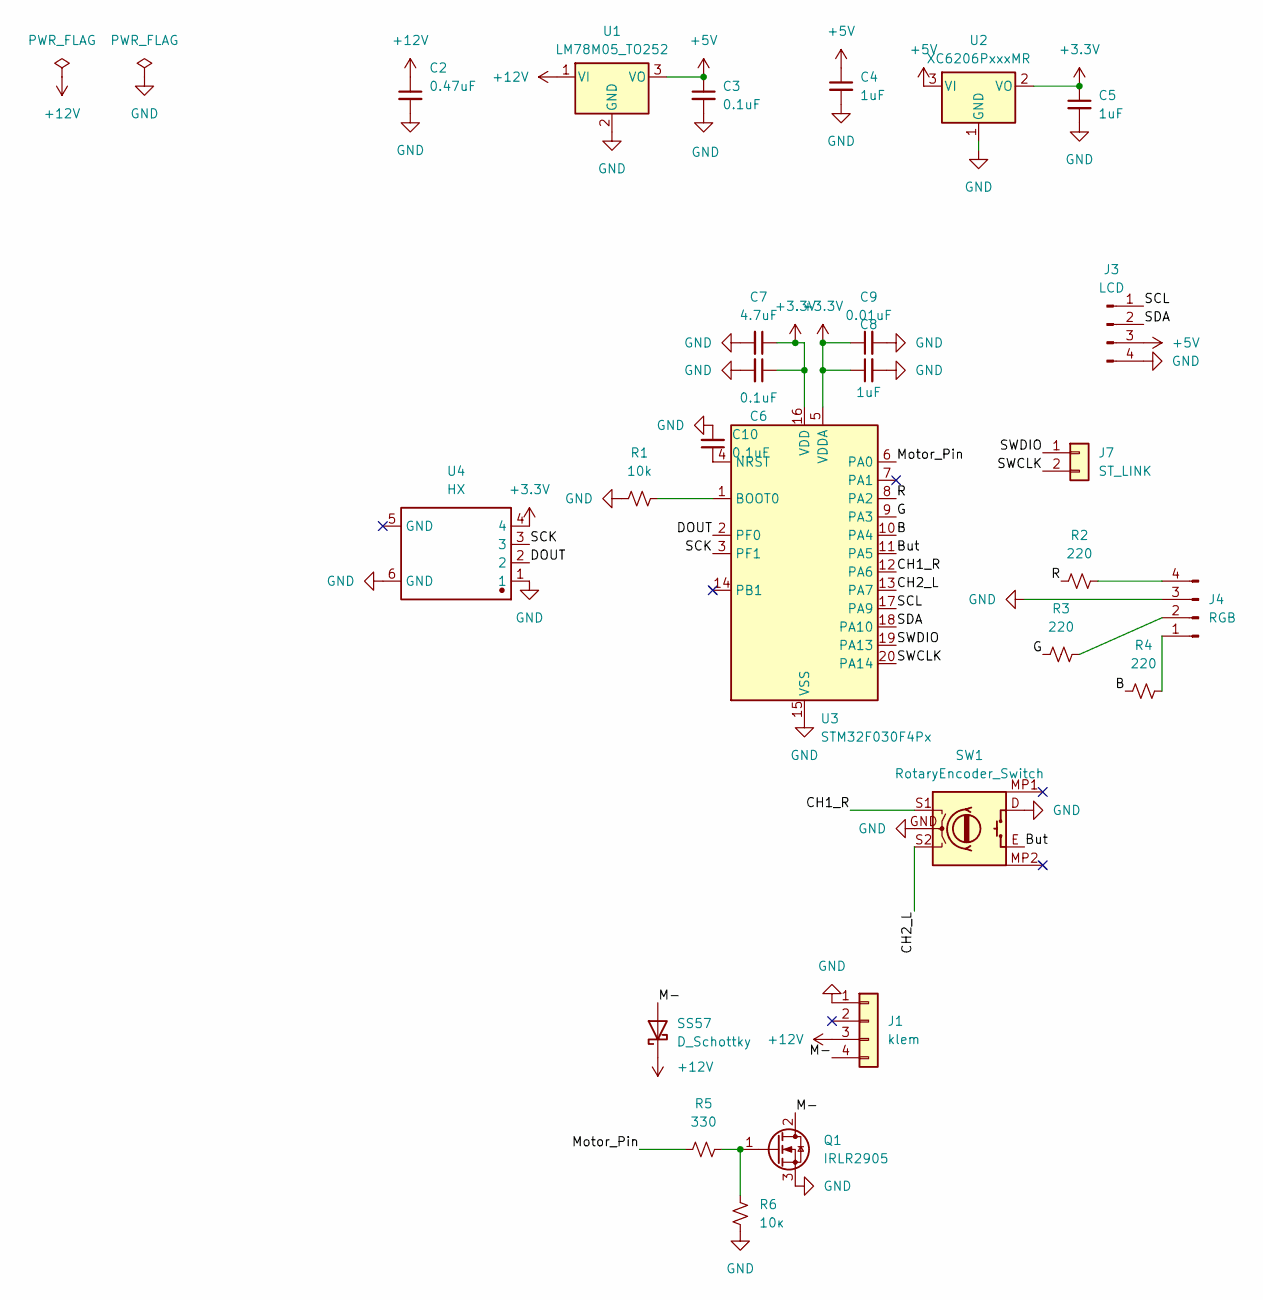
[picture p7: schematic doz_030_klem.kicad_sch]

Parts:
C2: 0.47uF; C_1206_3216Metric; Voltage 16V; Tolerance 20%
C3, C6, C10: 0.1uF; C_1206_3216Metric; Voltage 16V; Tolerance 20%
C4, C5, C8: 1uF; C_1206_3216Metric; Voltage 16V; Tolerance 20%
C7: 4.7uF; C_1206_3216Metric; Voltage 16V; Tolerance 20%
C9: 0.01uF; C_1206_3216Metric; Voltage 16V; Tolerance 20%
J1: klem; TerminalBlock_MaiXu_MX126-5.0-04P_1x04_P5.00mm
J3: LCD; PinHeader_1x04_P2.54mm_Vertical
J4: RGB; PinHeader_1x04_P2.54mm_Vertical
J7: ST_LINK; PinHeader_1x02_P2.54mm_Vertical
Q1: IRLR2905; TO-252-2
R1: 10k; R_1206_3216Metric
R2, R3, R4: 220; R_1206_3216Metric
R5: 330; R_1206_3216Metric
R6: 10к; R_1206_3216Metric
SS57: D_Schottky; D_SMC
SW1: RotaryEncoder_Switch; EC11_MY
U1: LM78M05_TO252; TO-252-2
U2: XC6206PxxxMR; SOT-23-3
U3: STM32F030F4Px; TSSOP-20_4.4x6.5mm_P0.65mm
U4: HX; USB_A_TH_MOLEX_67643_3910; Manufacturer Part 67643-3910

Connections:
+3.3V: C5.1, C6.1, C7.1, C8.1, C9.1, U2.2 (VO), U3.5 (VDDA), U3.16 (VDD), U4.4
+5V: C3.1, C4.1, J3.3, U1.3 (VO), U2.3 (VI)
+12V: C2.1, J1.3, SS57.1 (K), U1.1 (VI)
/B: R4.1, U3.10 (PA4)
/But: SW1.E, U3.11 (PA5)
/CH1_R: SW1.S1, U3.12 (PA6)
/CH2_L: SW1.S2, U3.13 (PA7)
/DOUT: U3.2 (PF0), U4.2
/G: R3.1, U3.9 (PA3)
/M-: J1.4, Q1.2 (D), SS57.2 (A)
/Motor_Pin: R5.1, U3.6 (PA0)
/R: R2.1, U3.8 (PA2)
/SCK: U3.3 (PF1), U4.3
/SCL: J3.1, U3.17 (PA9)
/SDA: J3.2, U3.18 (PA10)
/SWCLK: J7.2, U3.20 (PA14); also elsewhere on the board
/SWDIO: J7.1, U3.19 (PA13); also elsewhere on the board
GND: C2.2, C3.2, C4.2, C5.2, C6.2, C7.2, C8.2, C9.2, C10.2, J1.1, J3.4, J4.3, Q1.3 (S), R1.1, R6.1, SW1.D, SW1.GND, U1.2 (GND), U2.1 (GND), U3.15 (VSS), U4.1, U4.6 (GND)
unnamed: J4.1, R4.2
unnamed: J4.2, R3.2
unnamed: J4.4, R2.2
unnamed: Q1.1 (G), R5.2, R6.2
unnamed: R1.2, U3.1 (BOOT0)
unnamed: C10.1, U3.4 (NRST)

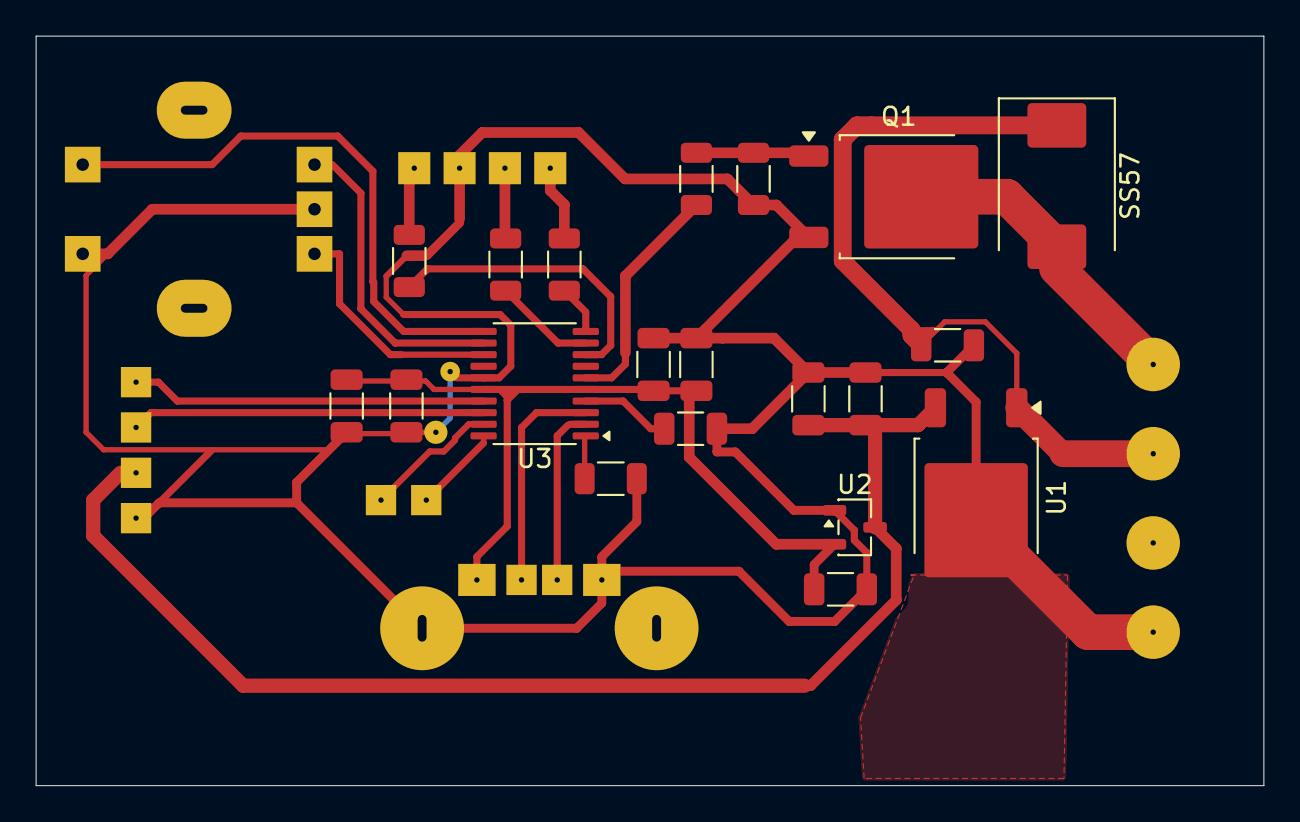
[picture p8: board doz_030_klem.kicad_pcb from above]

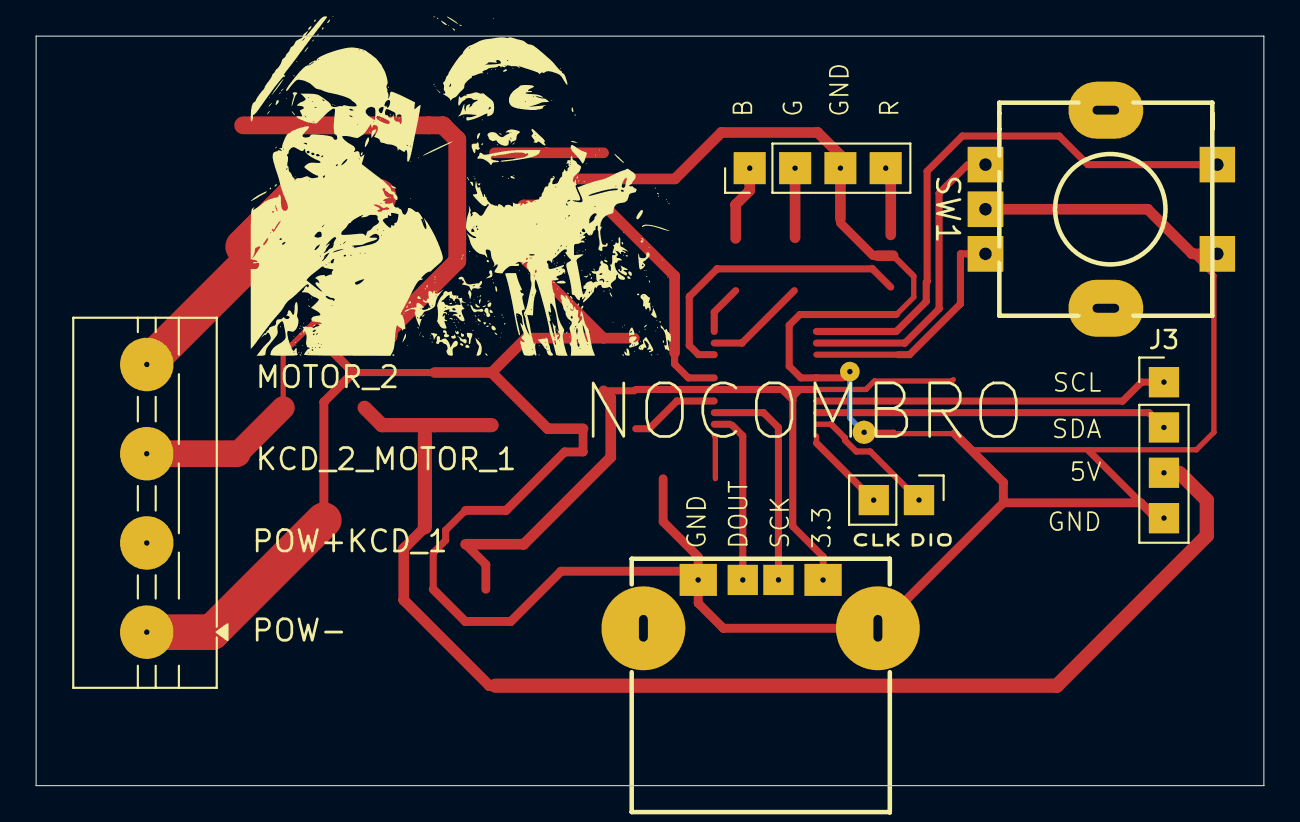
[picture p9: board doz_030_klem.kicad_pcb from below]

Board: 2 copper layers, 68.8 x 42.0 mm, 27 parts (7 on the bottom side), 24 nets.

Other parts of the board:
J: ST_LINK; PinHeader_1x02_P2.54mm_Vertical
a: LOGO

Their connections:
/SWCLK: J.2; also elsewhere on the board
/SWDIO: J.1; also elsewhere on the board
