pavlig43/Doz_stm32f103CBTx/stm32f030/Core/Src/main.c

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
/* Includes ------------------------------------------------------------------*/
#include "main.h"
#include "i2c.h"
#include "tim.h"
#include "gpio.h"

/* USER CODE BEGIN Includes */
#include "app.h"
#include "doz_fee.h"
#include "enc.h"
#include "hx.h"
#include "lcd.h"
#include "motor.h"
#include "rgb.h"

/* USER CODE END Includes */


void SystemClock_Config(void);
/**
  * @brief  The application entry point.
  * @retval int
  */
int main(void)
{

  /* MCU Configuration--------------------------------------------------------*/

  /* Reset of all peripherals, Initializes the Flash interface and the Systick. */
  HAL_Init();

  /* Configure the system clock */
  SystemClock_Config();

  /* Initialize all configured peripherals */
  MX_GPIO_Init();
  MX_I2C1_Init();
  MX_TIM1_Init();
  MX_TIM3_Init();
  /* USER CODE BEGIN 2 */

  Motor_Stop();
  RGB_Stop();
  FEE_Settings_Init();
  HX_Init();
  LCD_Init();
  Enc_Init();

  /* USER CODE END 2 */

  /* Infinite loop */
  /* USER CODE BEGIN WHILE */
  while (1)
  {
    /* USER CODE END WHILE */

    /* USER CODE BEGIN 3 */
    Enc_Update_Loop();
    Enc_Button_Loop();
    App_Loop();
    LCD_Loop();
  }
  /* USER CODE END 3 */
}

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
