pavlig43/Doz_stm32f103CBTx/stm32f030/Core/Inc/main.h

#define DOUT_Pin GPIO_PIN_0
#define DOUT_GPIO_Port GPIOF
#define SCK_Pin GPIO_PIN_1
#define SCK_GPIO_Port GPIOF
#define Motor_Pin GPIO_PIN_0
#define Motor_GPIO_Port GPIOA
#define R_Pin GPIO_PIN_2
#define R_GPIO_Port GPIOA
#define G_Pin GPIO_PIN_3
#define G_GPIO_Port GPIOA
#define B_Pin GPIO_PIN_4
#define B_GPIO_Port GPIOA
#define Enc_But_Pin GPIO_PIN_5
#define Enc_But_GPIO_Port GPIOA
#define EEPROM_START_ADDR 0x08003C00U
