pavlig43/Doz_stm32f103CBTx/Core/Inc/hx.h

#pragma once
#include <stdbool.h>
#include <stdint.h>


void HX_Init(void);
bool HX_Is_Ready(void);
bool HX_Read(int32_t *raw);
int32_t HX_Get_Average_5(void);
void HX_Tare(void);
int32_t HX_Get_Grams(void);
