pavlig43/Doz_stm32f103CBTx/Core/Src/utils.c

// utils.c
long map(long x, long in_min, long in_max, long out_min, long out_max) // Пересчёт одного диапазона в другой
{
    return (x - in_min) * (out_max - out_min + 1) / (in_max - in_min + 1) + out_min; // Возвращаем масштабированное значение
}
