pavlig43/Doz_stm32f103CBTx/(commit log)

2026-10-07 Initial import of STM32F103 dispenser firmware
2026-10-07 Update dosing settings and add calibration loop stub
2026-10-08 Add HX calibration steps to settings screen
2026-10-08 Fix settings navigation and store calibration factor in two records
2026-10-12 Implement HX711 readings with TIM1 and update settings calibration
2026-10-12 Remove unsolicited work screen and button taring
2026-10-18 Save current firmware state before timer readability refactor
2026-10-18 Save current firmware state before MCU project split
2026-10-22 Add doz_030 schematic, PCB and two-set LUT PDF
2026-10-25 Split MCU projects and add STM32F030 firmware support
2026-10-26 Move current KiCad project into firmware repository
2026-10-27 Update KiCad board and approved A4 toner-transfer PDF
2026-10-29 Update current KiCad board and keep latest LUT PDF
2026-11-05 Add doz_030_klem KiCad project
2026-11-06 Update terminal-block PCB and add project artifacts
2026-11-06 Update terminal-block PCB and print templates
2026-11-06 Place print templates 5 mm from top-left corner
2026-11-06 Use portrait A4 for PCB print templates
