pavlig43/Doz_stm32f103CBTx/(notices)

Notices in the files:
stm32f030/Core/Src/main.c:
Copyright (c) 2026 STMicroelectronics.
All rights reserved.
This software is licensed under terms that can be found in the LICENSE file
